IvBarriosUN/RPM-Hall-UN/archivos electro/Impresiones 3D/soporte de imanes para el eje.stl

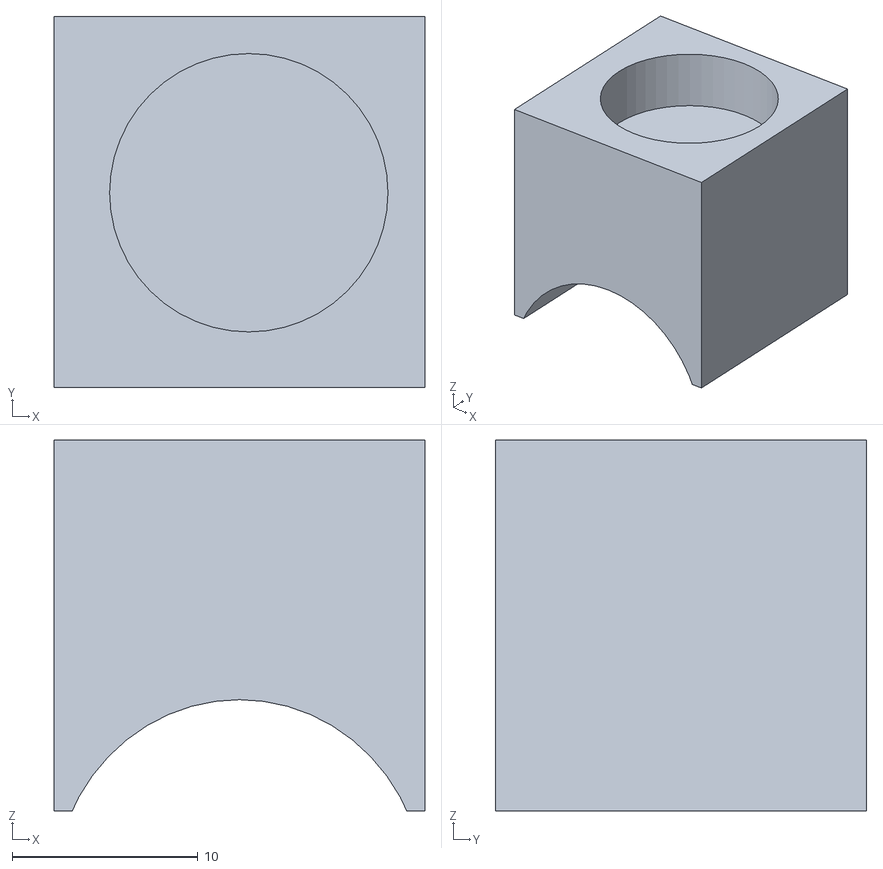
[picture p14: CAD file, 2025-06-04]
archivos electro/Impresiones 3D/soporte de imanes para el eje.stl
20.0 x 20.0 x 20.0
