IvBarriosUN/RPM-Hall-UN/archivos electro/Impresiones 3D/soporte para sensor efecto hall.stl

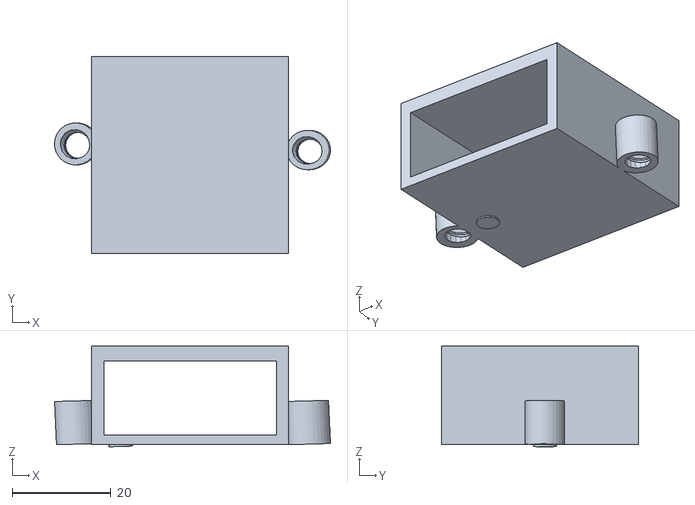
[picture p15: CAD file, 2025-06-04]
archivos electro/Impresiones 3D/soporte para sensor efecto hall.stl
56.0 x 40.0 x 20.4
