IvBarriosUN/RPM-Hall-UN/archivos electro/LTspice/Pruebas OpAmp.asc

C1: cap; 10n
M1: nmos; 2N7000
M2: nmos; 2N7000
M3: nmos; 2N7000
M4: nmos; 2N7000
M5: pmos; BS250
M6: nmos; 2N7000
M7: pmos; BS250
M8: pmos; BS250
R1: res; 10K
R2: res; 10K
R3: res; 10K
V1: voltage; 5
V2: voltage; SINE(2.5 0.05 1K); AC 1
V3: voltage; 2.5
Named nets: 0
;op
.lib 2N7000.lib
.ac dec 100 1 10G
.lib BS250.lib
.tran 0.01
