IvBarriosUN/RPM-Hall-UN/archivos electro/PCBs/Proyecto_prueba/Proyecto_prueba.kicad_pcb

## KiCad design archivos electro/PCBs/Proyecto_prueba/Proyecto_prueba.kicad_pcb (2025-06-04)

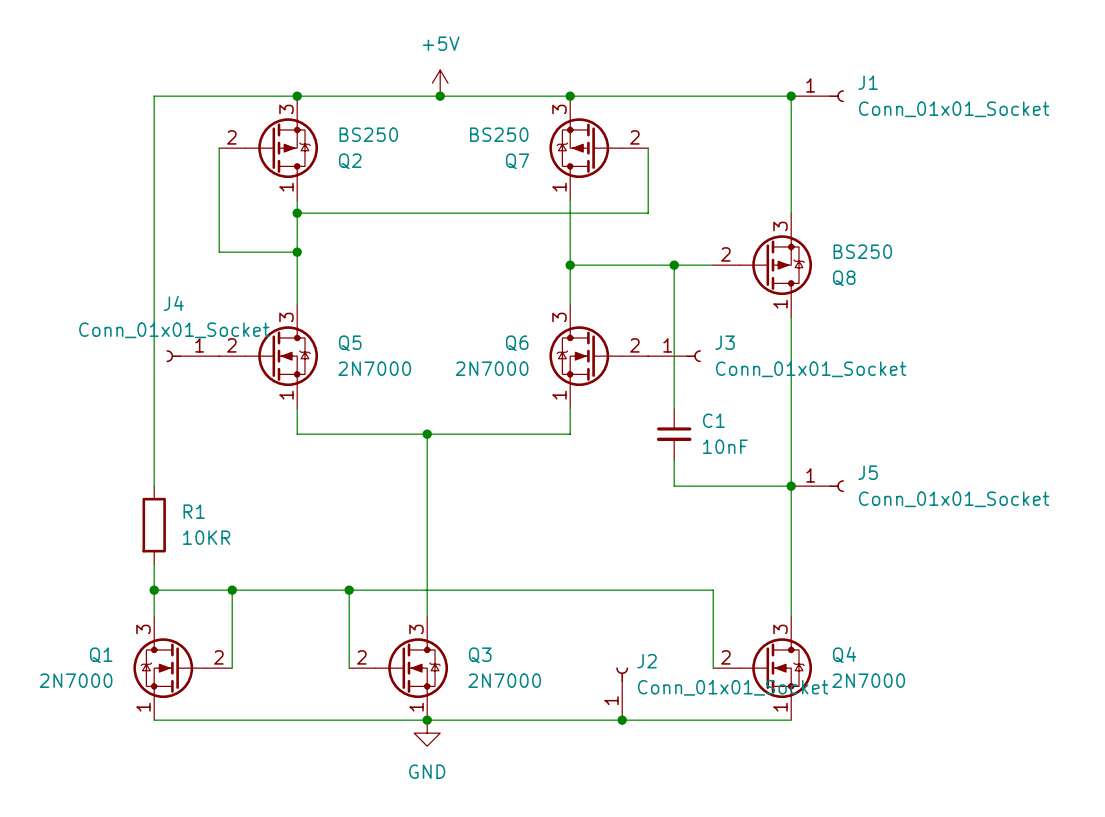
[picture p16: schematic Proyecto_prueba.kicad_sch]

Parts:
C1: 10nF; C_Disc_D3.0mm_W1.6mm_P2.50mm
J1, J2, J3, J4, J5: Conn_01x01_Socket; PinHeader_1x01_P2.54mm_Vertical
Q1, Q3, Q4, Q5, Q6: 2N7000; TO-92_Inline
Q2, Q7, Q8: BS250; TO-92_Inline
R1: 10KR; R_Axial_DIN0204_L3.6mm_D1.6mm_P5.08mm_Horizontal

Connections:
+5V: J1.1, Q2.3 (S), Q7.3 (S), Q8.3 (S), R1.1
GND: J2.1, Q1.1 (S), Q3.1 (S), Q4.1 (S)
unnamed: J3.1, Q6.2 (G)
unnamed: J4.1, Q5.2 (G)
unnamed: C1.2, J5.1, Q4.3 (D), Q8.1 (D)
unnamed: Q1.2 (G), Q1.3 (D), Q3.2 (G), Q4.2 (G), R1.2
unnamed: Q2.1 (D), Q2.2 (G), Q5.3 (D), Q7.2 (G)
unnamed: Q3.3 (D), Q5.1 (S), Q6.1 (S)
unnamed: C1.1, Q6.3 (D), Q7.1 (D), Q8.2 (G)

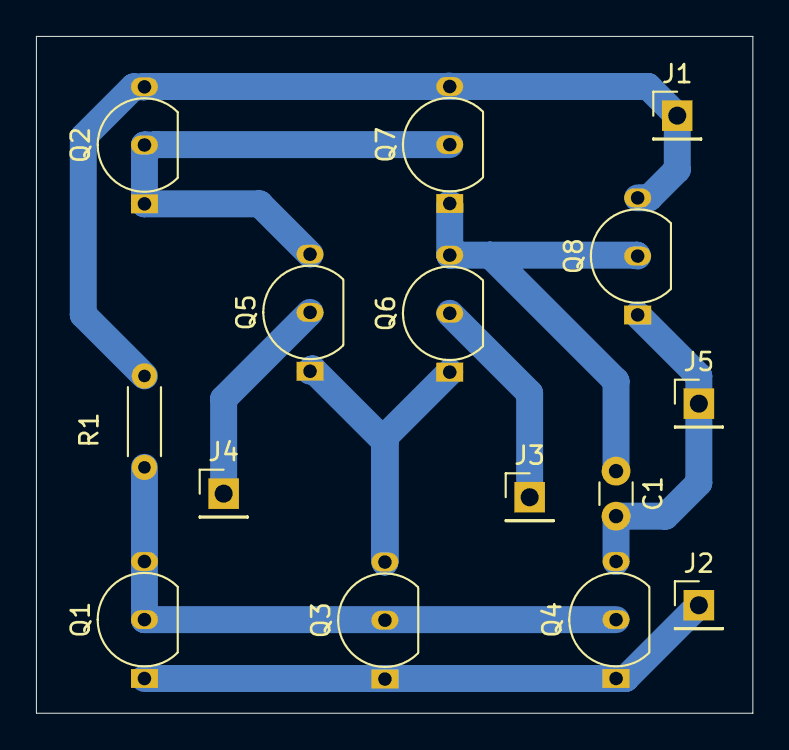
[picture p17: board Proyecto_prueba.kicad_pcb from above]

Board: 2 copper layers, 39.8 x 37.6 mm, 15 parts (0 on the bottom side), 9 nets.
