IvBarriosUN/RPM-Hall-UN/archivos electro/PCBs/Divisor pcb/Divisor pcb.kicad_pcb

## KiCad design archivos electro/PCBs/Divisor pcb/Divisor pcb.kicad_pcb (2025-06-04)

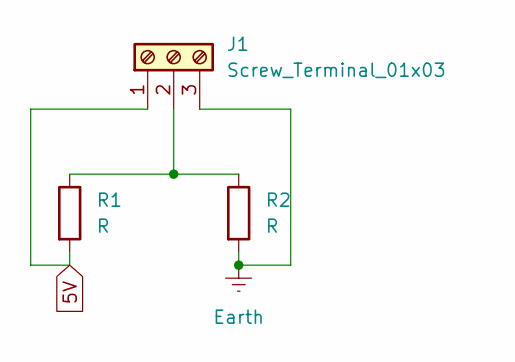
[picture p18: schematic Divisor pcb.kicad_sch]

Parts:
J1: Screw_Terminal_01x03; TerminalBlock_bornier-3_P5.08mm
R1, R2: R; R_Axial_DIN0309_L9.0mm_D3.2mm_P12.70mm_Horizontal

Connections:
5V: J1.1, R1.2
Earth: J1.3, R2.2
unnamed: J1.2, R1.1, R2.1

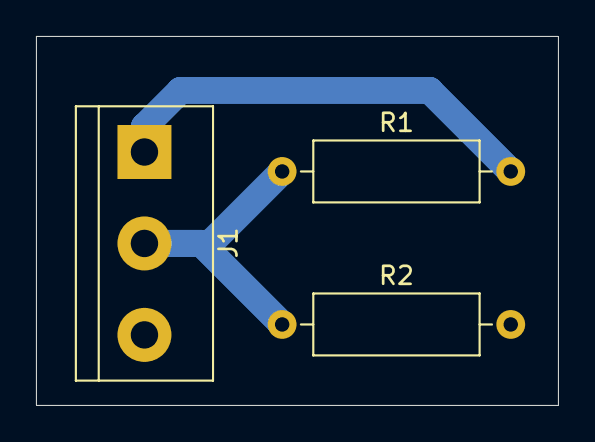
[picture p19: board Divisor pcb.kicad_pcb from above]

Board: 2 copper layers, 29.0 x 20.5 mm, 3 parts (0 on the bottom side), 3 nets.
