IvBarriosUN/RPM-Hall-UN/archivos electro/PCBs/Sensor Hall/Sensor hall.brd

## EAGLE design archivos electro/PCBs/Sensor Hall/Sensor hall.brd (2025-06-04)

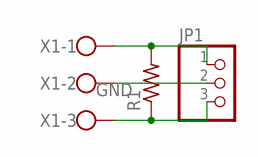
[picture p20: schematic Sensor hall.sch]

Parts:
JP1: PINHD-1X3; 1X03
R1: R-US_0411/15; 0411/15
X1: W237-103

Connections:
GND: JP1.2, X1.2
unnamed: JP1.1, R1.2, X1.1
unnamed: JP1.3, R1.1, X1.3

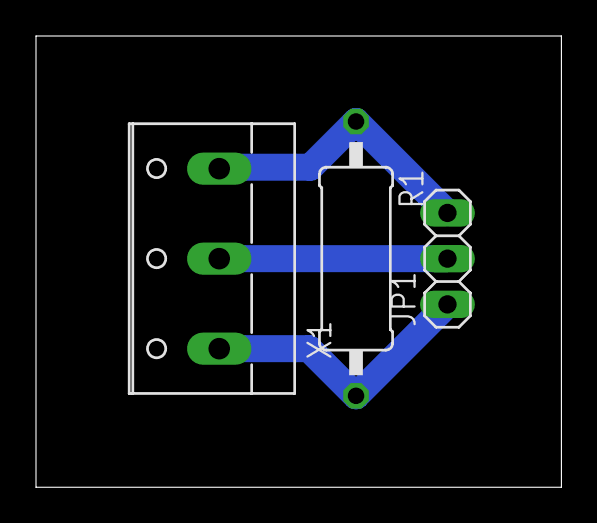
[picture p21: board Sensor hall.brd from above]

Board: 2 copper layers, 29.2 x 25.1 mm, 3 parts (0 on the bottom side), 3 nets.
